elf98/temperatur.nu-reporter-v2.5-esp32-c3/hardware/temperatur.nu-reporter-v2.5-revA.stl

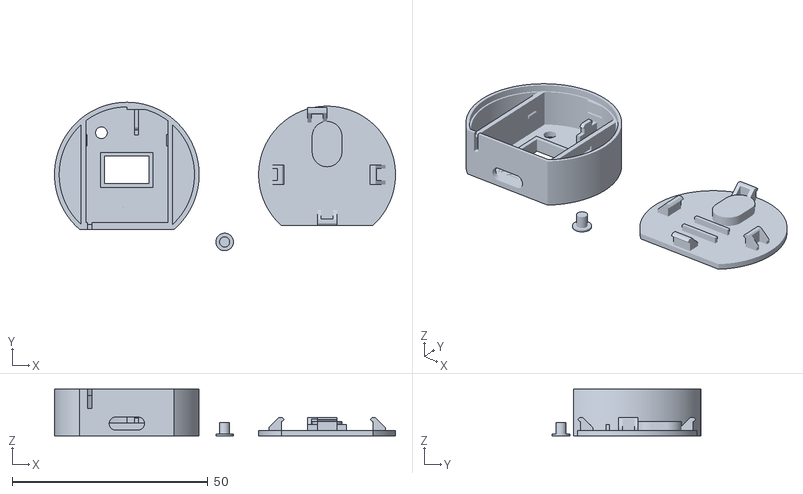
[picture p1: CAD file, 2026-11-08]
hardware/temperatur.nu-reporter-v2.5-revA.stl
87.2 x 38.0 x 12.0
