elf98/temperatur.nu-reporter-v2.5-esp32-c3/(commit log)

2026-04-25 Initial commit — Temperatur.nu Reporter v2.5 (ESP32-C3)
    WiFi-temperaturrapportör för temperatur.nu byggd kring ESP32-C3 SuperMini
    med inbyggd 0.42" OLED. Läser DS18B20 över 1-Wire (GPIO20/RX0), rapporterar
    till report.temperatur.nu och visar status på OLED-skärmen.
2026-04-26 Add OTA system, NTP clock, and display refinements
    Pull-OTA via http://report.temperatur.nu/firmware/esp32c3/ med
    versionerade .bin-filer (firmware-X.Y.Z.bin) och version.txt. Enheter
    checkar varje minut i DEV_MODE, en gång per dygn 02:00–04:00 i prod.
    Manuell trigger via långtryck på WiFi-skärmen.
    Ändringar:
    - TROTA-modul för pull-OTA (fetchLatestVersion / downloadAndFlash)
    - NTP-stöd med svensk tidszon, klocka på WiFi-skärmen
    - ISR-driven knapphantering (kort/medium/lång/extra-lång) så klick inte
    missas under blockerande operationer (sensor read, HTTP)
    - Långtrycks-stages: OTA / Portal / AVBRYT / RESET med textindikator
    - Config-portal i non-blocking läge — knapptryck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
    [TRDisplay.cpp, TRDisplay.h, TRESP.cpp, TRESP.h, TROTA.cpp, TROTA.h, temperatur_reporter_esp32c3.ino]
2026-04-26 Fix portal entry; ASCII display strings
    - Portal: wm.startConfigPortal() returnerar alltid false i non-blocking
    läge i WiFiManager 2.x — den check:en var fel och stängde portalen
    direkt efter öppning. Lös: ignorera returvärdet, lita på loop:ens
    process()-anrop för status.
    - Display: ASCII-substitution för åäö (Slapp, Soker, Hamtar, Portal
    stangd, ej nadd) — u8g2 drawStr förväntar 8-bit, källan är UTF-8 så
    flerbytestecken renderas trasigt.
    [TRDisplay.cpp, TRESP.cpp, temperatur_reporter_esp32c3.ino]
2026-11-01 Switch to No FS partition scheme and new OTA channel (2.6.0)
    The app outgrew the 1.25 MB slot of Default 4MB with core 3.3.12. The
    firmware uses no filesystem, so No FS 4MB gives 2 MB per OTA slot.
    OTA cannot change the partition table, so 2.6.0 reads its own channel
    firmware/esp32c3-nofs/. The old esp32c3/ channel stays frozen at 2.5.0 for
    devices still on the old table; they need one USB flash to move over (NVS
    is at the same offset, so WiFi and settings survive).
    deploy_firmware.ps1 now targets the new channel, creates it on the server,
    and refuses a bin not built with the No FS table or too large for the slot.
    [TROTA.cpp, temperatur_reporter_esp32c3.ino]
2026-11-01 2.6.0 release: CDC on boot, display fixes, flash test script
    The first 2.6.0 bin was built with USB CDC On Boot disabled (the IDE reset
    board options on the core update), which frees GPIO20 for UART0 and can
    break 1-Wire. Rebuilt with CDCOnBoot=cdc and redeployed as 2.6.0; the bin
    here matches the server.
    - deploy_firmware.ps1 refuses builds without CDCOnBoot=cdc
    - statusScreen falls back to 6x13B when a heading is wider than 72 px
    ("Ingen ny FW" etc. were clipped); "Portal stangd" -> "Portal av"
    - Long press: releasing at >= 20 s cancels instead of wiping WiFi, so
    holding too long no longer always ends in RESET
    - flash_test.ps1: production flashing - erase NVS, flash, provision WiFi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
    [TRDisplay.cpp, temperatur_reporter_esp32c3.ino]
2026-11-03 2.6.1: sensortest i AP-läget via knapptryck
    Portalen vid uppstart körs icke-blockerande så att knappen kan växla
    mellan AP-skärmen och S1/S2 medan portalen är aktiv. Sensorerna läses
    asynkront (portalen fryser inte), bussen söks om vid varje avläsning och
    S2 visas alltid ("---" om den saknas). Sensorerna initieras före WiFi.
2026-11-06 flash_test: hoppa över flashning om bygget redan finns, GIVARFEL
    - MAC/PIN läses från chippet (read-mac), så de aldrig blir "?"
    - verify-flash mot bygget: redan flashad enhet testas bara
    - missad uppstartsutskrift: försök ansluta till portalen ändå efter 12 s
    - givare som ger -127/85 ger resultatet GIVARFEL i stället för OK
2026-11-08 Lådan: STL rev A för reporter v2.5
    [temperatur.nu-reporter-v2.5-revA.stl]
